patmakesapps/LumaLight/cad/LUMALIGHT_SPEC.md

# LumaLight — enclosure spec (v2.1, open back, 2026-10-12)

Modelled in `LumaLight.blend` (Blender 5.1, 1 BU = 1 mm). Assembly sits at the origin in **LUMALIGHT ASSEMBLY**
(`LUMALIGHT PRINT PARTS` + linked electronics in `LUMALIGHT PLACED PARTS`). Electronics are parked at x 300+ in
numbered collections; the L-mark and wordmark are in `LOGOS`. Body coordinates: X = width (centred), Y = depth
(front outer face y = 0, back of the panel y = 56), Z up from the counter. Cutaway views are in `views/`.

The print parts are generated by `build_lumalight.py` (CadQuery 2.8 on Python 3.12). It writes the print-oriented
STLs to `STL/` and assembly-oriented `asm_*.stl` meshes (to `%LUMALIGHT_ASM_DIR%`, default a temp folder) that are
imported into the blend to replace the part meshes. Change the numbers in the script, not the meshes.

## Why v2

v1 (bottom plate + spine, 40 deep) failed on the bench: the dupont housings on the ESP32 pins pointed at the
front wall with 0.5 mm to the ring pocket, and the ToF board had to be threaded down from the top past them with
its JST and cable attached (`bench reference/bad_design _01/_02.jpg`). v2 opens the **back** instead of the bottom,
hangs the ESP32 on the back panel, gives the wires an 18 mm bay, and makes the sensor a push-in-from-behind part.
Everything can be wired on the bench first.

## v2.1 (same day, after the sensor coupon)

The v2 pocket coupon showed the slit sitting about 3 mm below the real VL53L1X package, and the two snap fingers
barely holding the board. The board blockout had been eyeballed from photos (26.5 tall, package 21.5 up). The
CQRobot board is really 23 x 28.5 with R4 corners, both Ø3 holes at the top corners, the package 24.65 above the
cable edge. The ROLX-4 model of the board (`ROLX-4/cad/ROLX-4.blend`) is now appended and used in the assembly.
The sensor is screwed to two blocks instead of clipped, the window is re-centred on the package, and the ESP32
standoffs on the panel get a relieved neck (see the ESP32 row; the v2 panel already printed stays in use).

## Concept

An upright white monolith, 62 × 56 × 100 mm (body 53 deep + 3 mm back panel), vertical front edges chamfered 2.5,
top edges 1 mm. The front carries a Ø46 halo (transparent diffuser disc, NeoPixel ring behind it) and an 11 × 7 mm
rounded "visor" port for the ToF sensor below it. The LUMALIEN L-mark is recessed into the top face with purple
glued inlays; **LUMALIGHT** is recessed on the front near the base, **LUMALIEN** on the back panel. The back panel is
held by 4 screws into corner bosses; the USB-C cable leaves through a notch at the bottom of the panel.

## Layout (mm)

| Item | Position | Notes |
|---|---|---|
| Walls | 3.0 everywhere | cavity x ±28, y 3..53, z 3..97, open at the back |
| Halo | centre (0, z 65) | through hole Ø40; front recess Ø46 × 1.5 for the diffuser flange |
| Ring pocket rib | inner front wall, ID 37.4 / OD 44, y 3..9.5 | ring loads from the **front** through the Ø40 hole, LEDs forward, 0.3 radial play |
| Stop tabs | 3 tabs at 90°/210°/330°, 20° of arc, 1.5 inward, front face y 8.3 (45° underside to y 6.8 at the root) | ring back face rests at y 8.3; LED tops at y 4.7, 1.7 air gap to the diffuser; rotate the ring so its pads miss the tabs |
| Diffuser | flange Ø45.8 × 1.5 + boss Ø39.7 × 1.5, flush with the front | glued in; it captures the ring. Unchanged from v1 |
| Sensor window | 11 × 7 stadium through the wall, centre (0, z 36.95), 0.5 mm outward chamfer (12 × 8 at the face) | centred on the VL53L1X package. The 27° cone from the package (8.4 mm behind the face) needs 9 × 5.5 at the face, so there is about 1 mm of slack each way. Top of the flare is 1 mm below the diffuser recess |
| Sensor board | CQRobot VL53L1X, 23 wide × 28.5 tall, R4 corners, x ±11.5, PCB y 10..11.6, z 12.3..40.8, cable edge down | component side (package **and** 6-pin JST) faces the wall; package centre 24.65 above the cable edge; Ø3.0 holes at (±8.2, 37.6) = 25.3 above the cable edge; JST 16.6 wide × 4.6 tall at y 5.4..10, plug overhangs the edge 0.5; cable turns under the board in x ±7.1, 9.3 mm to the floor |
| Sensor mount | seats y 3..10 at \|x\| 10.5..15.7 (a 1 mm band under each board edge); cheeks y 10..12.7 at \|x\| 12.25..15.7 (0.75 play); both z 10.3..40.8. Screw blocks \|x\| 5.9..15.7, y 3..10, z 35.1..40.1, Ø2.0 pilots 6.5 deep at (±8.2, 37.6) | board is **pushed straight on from the back** between the cheeks until its face sits on the seats, then 2 × M2.5 × 6 self-tap through its top holes, driven from the open back. No bottom ledge, no fingers, nothing touching the rounded corners: the screws set the position. Blocks stop 0.4 short of the window |
| ESP32 | vertical on the back panel, USB-C down, bottom edge z 42, centred in X; PCB y 44.4..46, components toward the panel, pins toward the front | header plastic y 41.9..44.4, dupont housings y 27.9..41.9 |
| Wire bay | y 9.5 (rib back) .. 27.9 (housing tips) | 18.4 mm for the dupont leads to turn; 19.6 mm to the ring's back face; plus 14 mm of free channel each side of the ESP32, full depth |
| Standoffs (on the panel) | 4 × Ø6 × 7 at (±11.6, z 44.5) and (±11.6, z 91.3), Ø2.0 pilots 9 deep (into the panel, 1 mm short of the outer face). **v2.1:** the USB-end pair have an open-sided C neck for the first 3.6 mm from the PCB: Ø5, clipped 1.0 above the hole centre, nothing on the button side | the EN/BOOT buttons sit 1.5 mm above those two holes (z 46..52, 3.5 tall) and the v2 Ø6 standoffs pressed on them when tightened (bench). 4 × M2.5 self-tap: × 8 at the USB end so the screw reaches the full-round section, × 6 or × 8 at the top. The v2 panel in use is fine for this build |
| USB-C plug | hangs below the board, overmold centred y ≈ 47.6, keepout x ±6, y 44..51.5, z 14..41 | 1.5 mm to the panel; cable turns in the 11 mm above the floor |
| Back panel | 62 × 100 × 3 at y 53..56, back vertical edges chamfered 2.5, top-back edge 1.0 | 1.5 mm alignment lip (frame 1.5 wide, 55.4 × 93.4) enters the cavity; relieved at the corners and the notch |
| Panel screws | 4 at (±25, 6) and (±25, 94): Ø2.8 through, counterbore Ø5.5 × 1.5 from the outside | into 6 × 6 × 10 corner bosses in the body (y 43..53), Ø2.0 pilots 8 deep; M2.5 × 8 self-tap, driven from the back |
| Cable notch | 10 wide × 16 tall, rounded top, bottom centre of the panel, open at the bottom edge | cable exits backward along the counter |
| Top L-mark | 22 tall, centred on the top face (y 17..39), 1.2 deep | purple inlays unchanged (0.15 clearance, 1.4 thick → 0.2 proud); glue in |
| Text | LUMALIGHT front, centre z 11; LUMALIEN on the panel, centre z 23; Segoe UI Bold 7, 0.6 deep | |

## Print parts (5)

| Part | Material | Orientation |
|---|---|---|
| LUMALIGHT BODY | white | **front face on the bed**, open back up, no supports. The front gets the plate texture; every inner feature (rib, tabs, seats, blocks, bosses) grows straight up |
| LUMALIGHT BACK PANEL | white | outer face on the bed, standoffs and lip up, no supports |
| LUMALIGHT DIFFUSER | transparent | flange face down (bed texture frosts it) |
| LUMALIGHT LOGO INLAY L / TRI | purple | flat |
| TEST_SENSOR_POCKET (`STL/test/`) | any | front face down. 44 × 48 slab of the front wall with the pocket, window, screw blocks and floor stub, ~20 min. Print this before the body |

STLs in `STL/`, print orientation, 1:1 mm. Hardware: 4 × M2.5 × 6 self-tap (ESP32 top pair, sensor) and 6 × M2.5 × 8
self-tap (ESP32 USB-end pair, panel to body). No inserts, no magnets, every screw driven along its axis from
outside the part. Glue: diffuser, inlays.

## Assembly order (everything pre-wired)

1. On the bench: screw the ESP32 to the panel standoffs, components toward the panel, pins toward you. Feed the
   USB-C cable through the panel notch from the outside and plug it in. Plug the sensor's leads and the ring's
   leads onto the pins. The whole harness is now live and the body is still empty.
2. Sensor: hold the board by its edges with the JST toward the front wall and the cable hanging down. Push it
   straight into the pocket from the back between the cheeks until its face sits on the seats. Line the two top
   holes up on the pilots (you can see them through the holes) and run in 2 × M2.5 × 6. Tuck the cable under
   the board toward the back.
3. Ring: in from the front through the halo hole, wires first, LEDs facing out, until it seats on the three tabs.
   Turn it so the solder pads sit between tabs. The panel just lies behind the body while you do this; the leads
   are long enough to stay plugged in.
4. Glue the diffuser into the front recess. The ring is now captured.
5. Bring the panel up to the body, fold the dupont leads into the bay, seat the lip, 4 screws from the back.
6. Glue the purple inlays into the top recess.

To service it: 4 screws, the panel comes away with the ESP32 on it and everything stays plugged in.

## Verify on the bench before/after printing

- Sensor screw spacing: the pilots are 16.4 mm apart, between the vendor drawing (16.1) and the ROLX-4 model
  (16.8); the board's Ø3 holes give ±0.25 mm on an M2.5. Caliper the real centre spacing; outside 15.9..16.9 the
  pilots move.
- Window: with the board screwed into the coupon, both package apertures must be fully visible through the
  window with clear margin all round. The window is centred 24.65 mm above the cable edge (drawing and ROLX-4
  model agree); if the real package sits elsewhere the window moves, nothing else does.
- The JST is modelled 4.6 tall (ROLX-4 model) with 2.4 mm to the wall; the earlier 6 mm guess also cleared.
- Dupont housings modelled 14 mm long on 2.5 mm header plastic. Bay is 18.4 mm; the ring pads sit at y 8.3.
- Cable under the sensor: 9.3 mm from the cable edge to the floor (was 12 in v2; the board moved down with the
  real package height). Check the six silicone leads turn back without pushing on the board.

## Suggested print order

1. `STL/test/TEST_SENSOR_POCKET.stl` (~20 min): push the real board in, run the two screws, look through the
   window, check the cable turns under the board.
2. `LUMALIGHT_BACK_PANEL.stl` (v2.1 standoffs; the printed v2 panel is fine for this build): screw the ESP32 on
   with all leads plugged, hold a ruler against it. From the panel's inner face the housing tips reach 25 mm; the
   ring's back is 44.7 mm away, the front wall 50 mm.
3. Only then the body.

Views: `views/cutaway_sensor_pocket.png` and `views/cutaway_sensor_seated.png` show the v2.1 pocket;
`views/cutaway_assembly.png` is the v2 overview and still shows the old slit and fingers.
