patmakesapps/LumaLight/cad/bench reference/bad_design _01.jpg

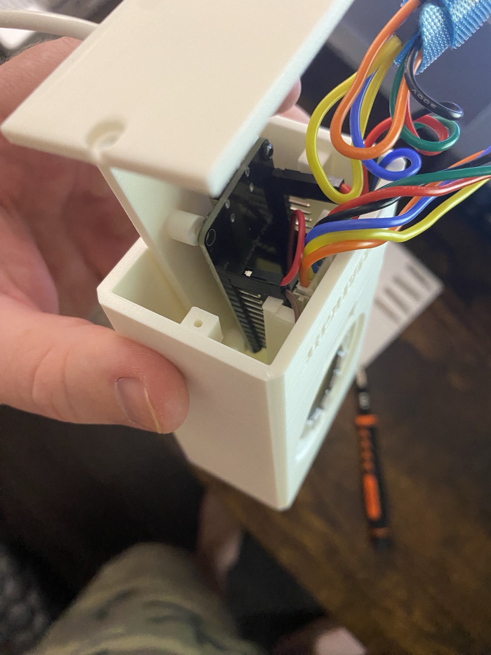
cad/bench reference/bad_design _01.jpg
