patmakesapps/LumaLight/cad/bench reference/bad_design _02.jpg

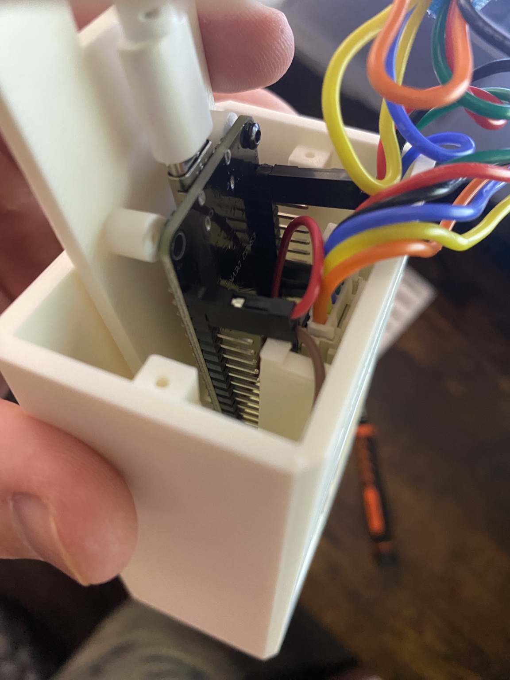
cad/bench reference/bad_design _02.jpg
