patmakesapps/LumaLight/cad/bench reference/bench_00.jpg

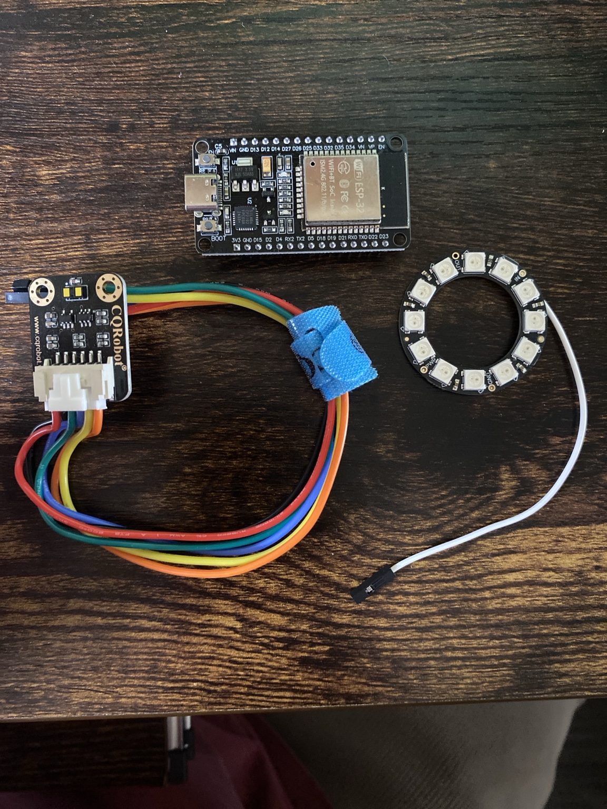
cad/bench reference/bench_00.jpg
