patmakesapps/LumaLight/cad/bench reference/distance_sensor_01.jpg

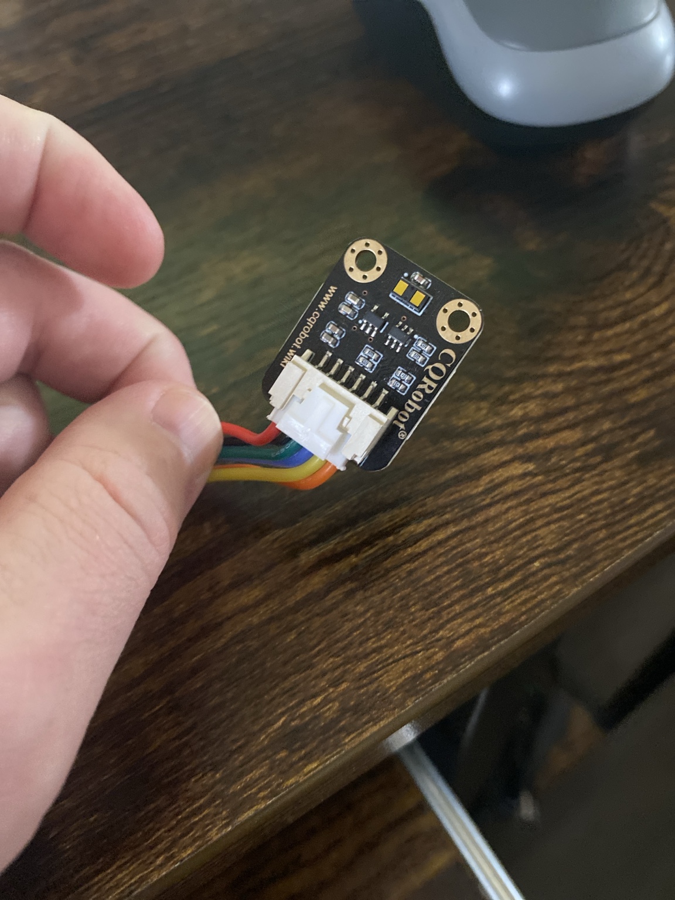
cad/bench reference/distance_sensor_01.jpg
