patmakesapps/LumaLight/cad/bench reference/esp_with_pins_02.jpg

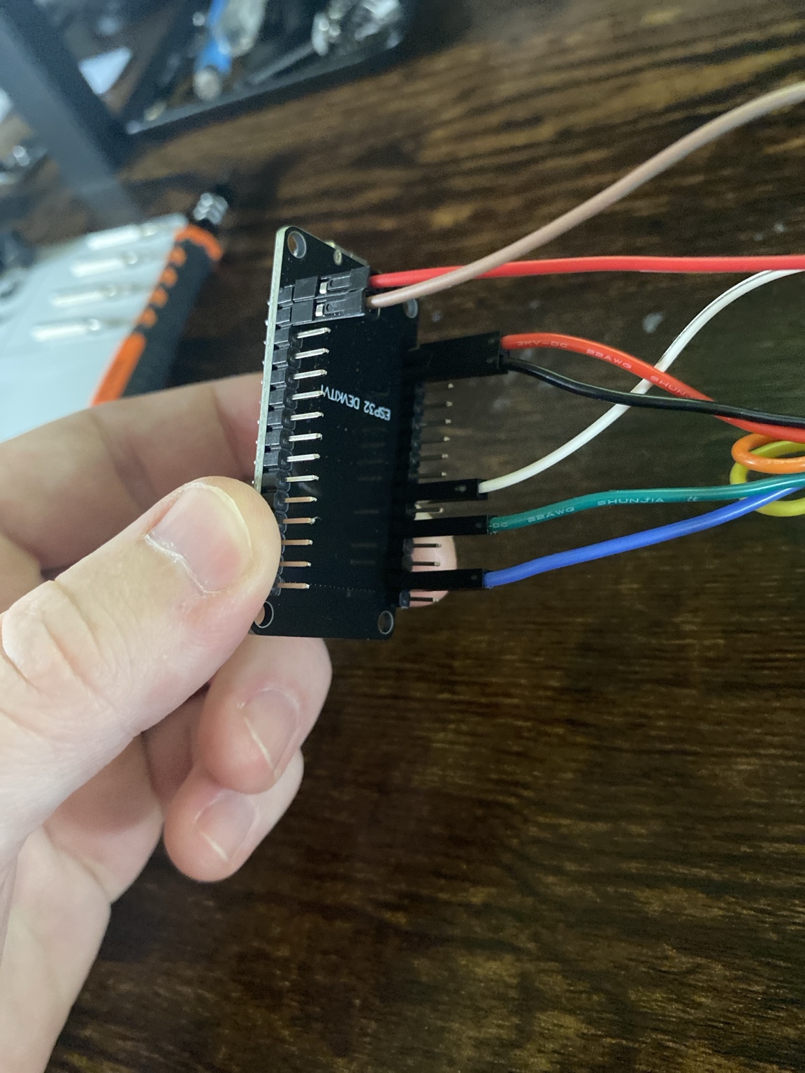
cad/bench reference/esp_with_pins_02.jpg
