patmakesapps/LumaLight/cad/bench reference/neo_pixel_rear_03.jpg

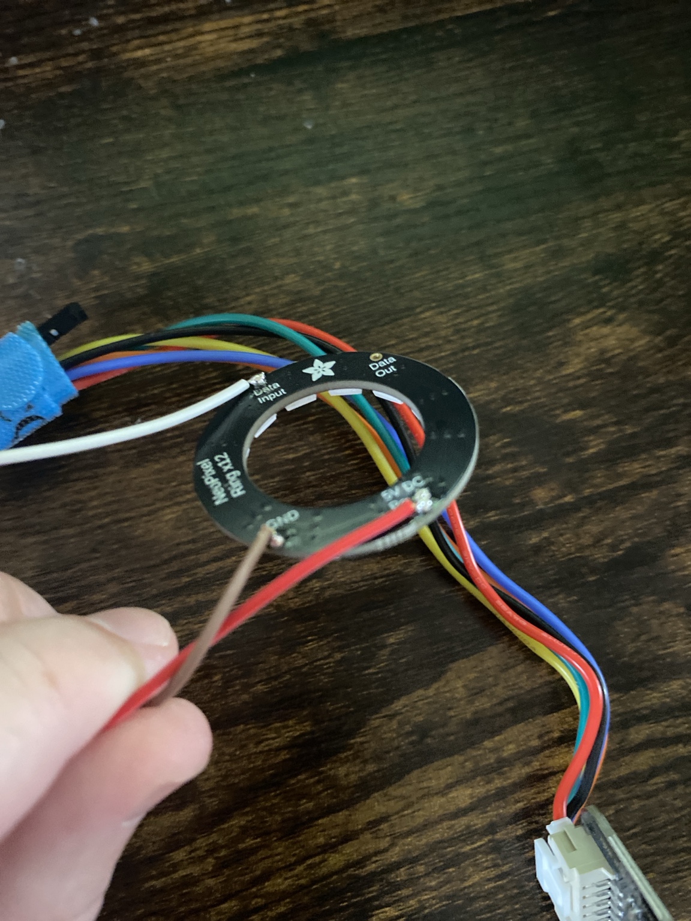
cad/bench reference/neo_pixel_rear_03.jpg
