patmakesapps/LumaLight/cad/views/cutaway_sensor_pocket.png

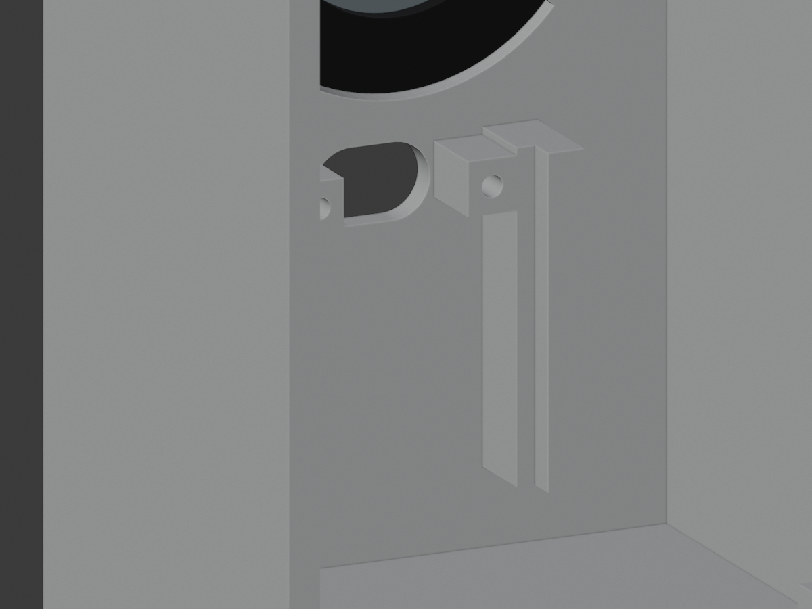
cad/views/cutaway_sensor_pocket.png
