patmakesapps/LumaLight/cad/views/cutaway_sensor_seated.png

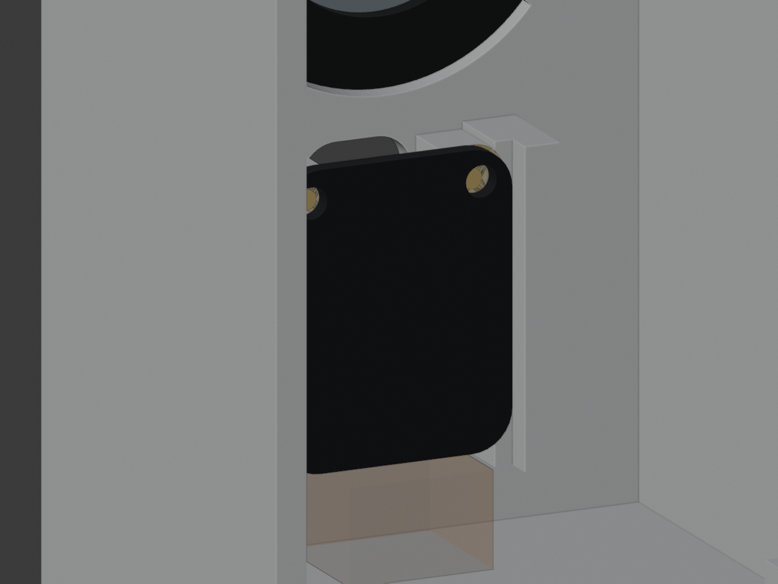
cad/views/cutaway_sensor_seated.png
