patmakesapps/LumaLight/cad/STL/LUMALIGHT_BODY.stl

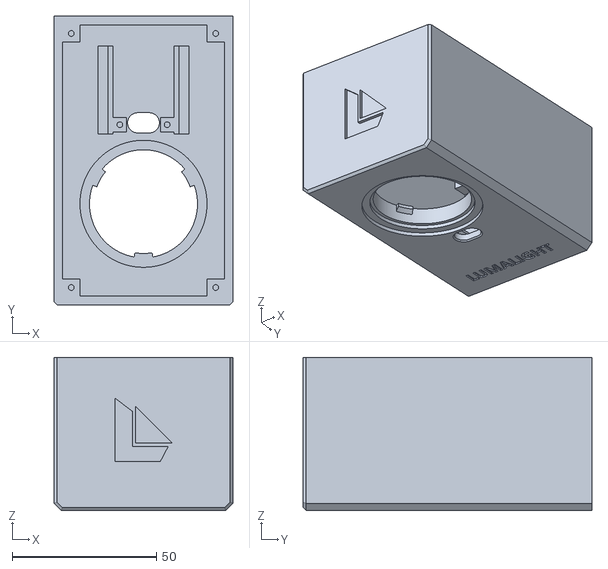
[picture p13: CAD file, 2026-10-13]
cad/STL/LUMALIGHT_BODY.stl
62.0 x 100.0 x 53.0
