patmakesapps/LumaLight/cad/STL/test/TEST_SENSOR_POCKET.stl

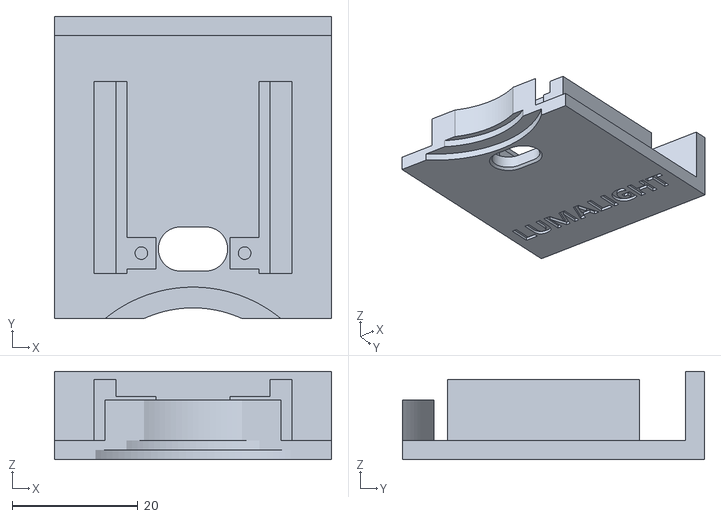
[picture p14: CAD file, 2026-10-13]
cad/STL/test/TEST_SENSOR_POCKET.stl
44.0 x 48.0 x 14.0
