patmakesapps/LumaLight/cad/STL/LUMALIGHT_BACK_PANEL.stl

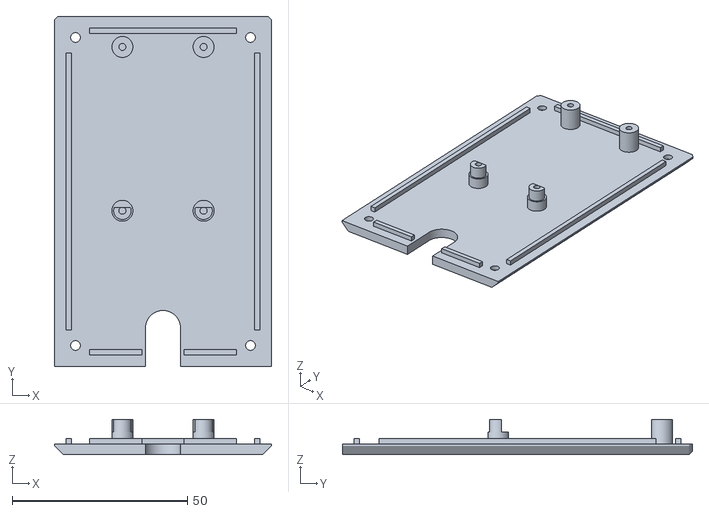
[picture p15: CAD file, 2026-10-13]
cad/STL/LUMALIGHT_BACK_PANEL.stl
62.0 x 100.0 x 10.00
