patmakesapps/LumaLight/cad/STL/LUMALIGHT_DIFFUSER.stl

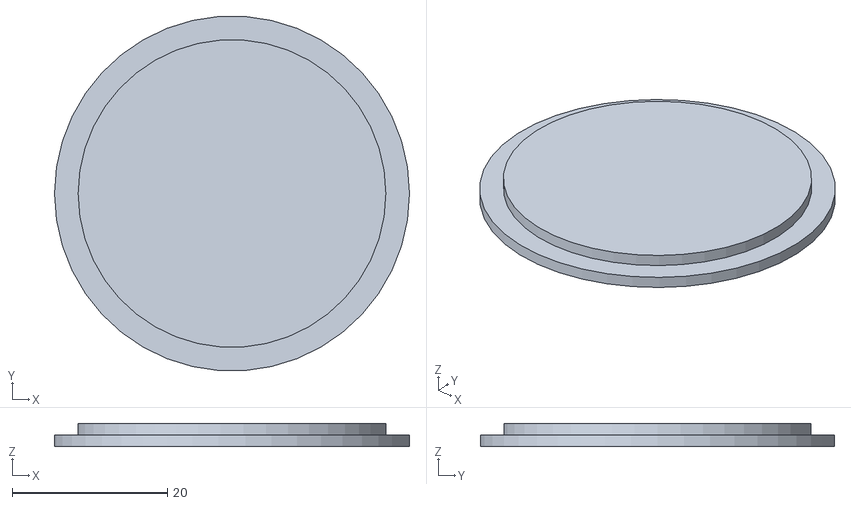
[picture p16: CAD file, 2026-10-12]
cad/STL/LUMALIGHT_DIFFUSER.stl
45.8 x 45.7 x 3.00
