patmakesapps/LumaLight/cad/STL/LUMALIGHT_LOGO_INLAY_TRI.stl

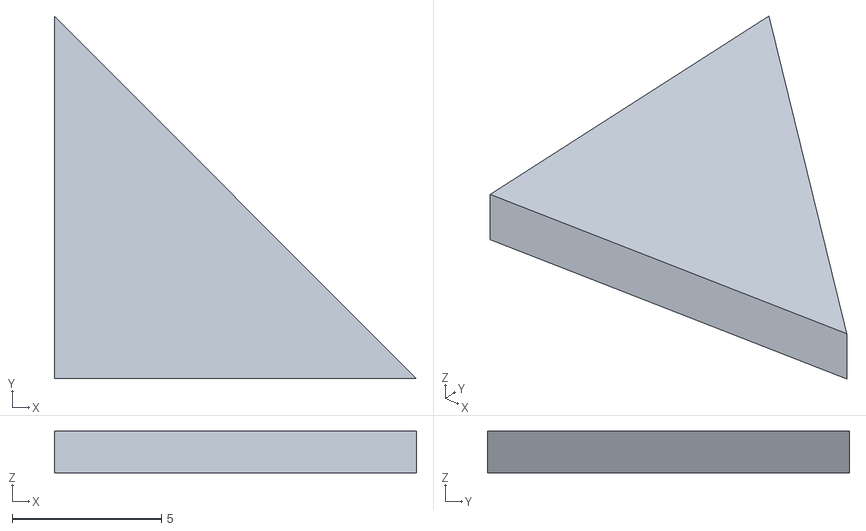
[picture p17: CAD file, 2026-10-12]
cad/STL/LUMALIGHT_LOGO_INLAY_TRI.stl
12.1 x 12.1 x 1.40
