patmakesapps/LumaLight/cad/STL/LUMALIGHT_LOGO_INLAY_L.stl

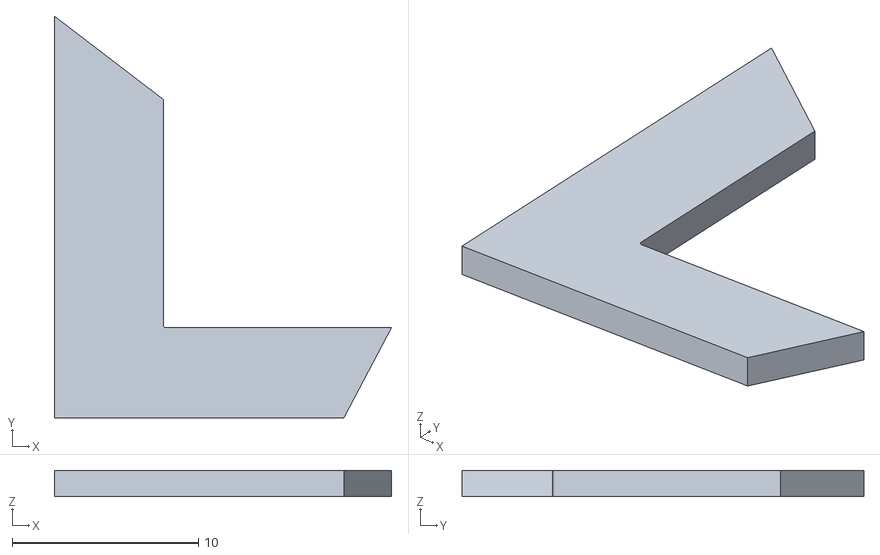
[picture p18: CAD file, 2026-10-12]
cad/STL/LUMALIGHT_LOGO_INLAY_L.stl
18.1 x 21.5 x 1.40
