patmakesapps/LumaLight/(list of files, cad)

Other CAD files:
cad/LumaLight.blend
