patmakesapps/LumaLight/cad/bench reference/full_assembly_04.jpg

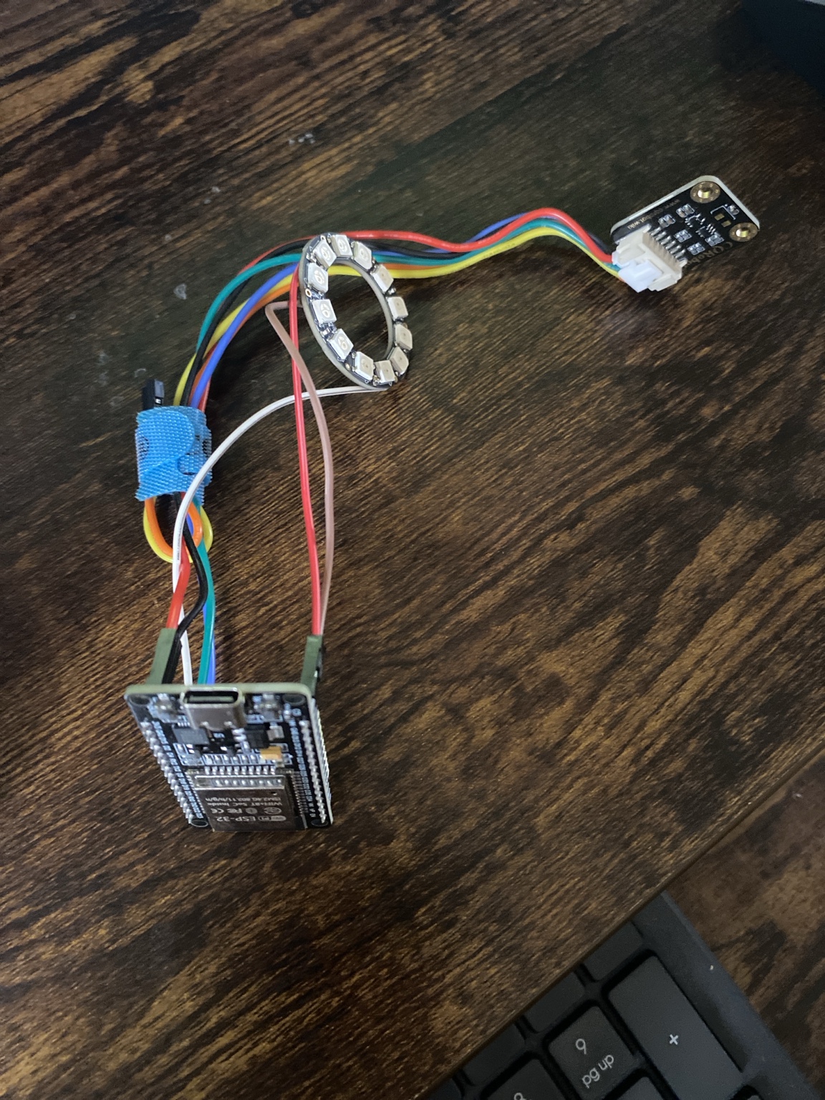
cad/bench reference/full_assembly_04.jpg
