patmakesapps/LumaLight/cad/views/cutaway_assembly.png

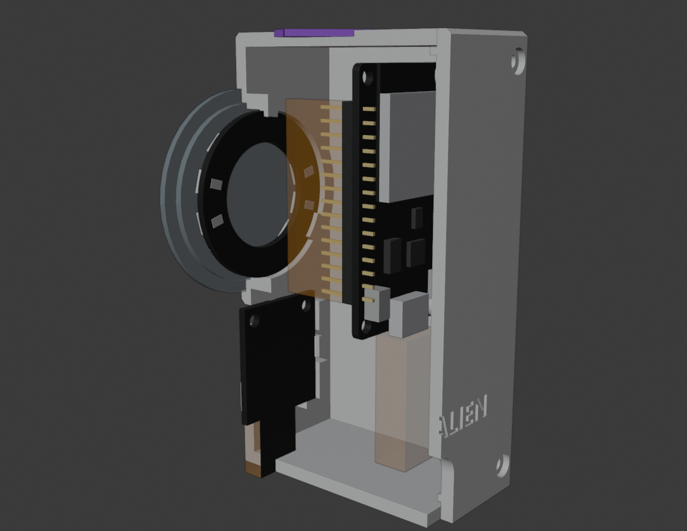
cad/views/cutaway_assembly.png
