patmakesapps/LumaLight/include/secrets.example.h

#pragma once

// Copy to include/secrets.h and fill in. secrets.h is git-ignored.
// 2.4 GHz networks only.
constexpr const char* WIFI_SSID = "your-network";
constexpr const char* WIFI_PASSWORD = "your-wifi-password";

// Must match --auth in secrets.ini
constexpr const char* OTA_PASSWORD = "choose-a-flashing-password";
