patmakesapps/LumaLight/(commit log)

2026-10-12 Add LumaLight enclosure CAD: Blender model, spec, STLs, bench reference
    Upright monolith enclosure (62 x 40 x 100 mm) designed around the bench
    hardware: ESP32 DevKit V1 (USB-C) on a base-plate spine, CQRobot VL53L1X
    in slide-in rails behind a visor slit, NeoPixel ring 12 front-loaded into
    a tabbed pocket behind a glued transparent diffuser. Recessed L-mark on
    top with purple inlays, LUMALIGHT / LUMALIEN text front and back, cable
    notch at the back-bottom.
    cad/LumaLight.blend model, 1 BU = 1 mm, electronics blockouts + logos
    cad/LUMALIGHT_SPEC.md layout numbers, print list, hardware, assembly order
    cad/STL/ 5 print parts, print orientation, watertight
    cad/bench referenc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
    [LUMALIGHT_BASE_PLATE.stl, LUMALIGHT_BODY.stl, LUMALIGHT_DIFFUSER.stl, LUMALIGHT_LOGO_INLAY_L.stl, LUMALIGHT_LOGO_INLAY_TRI.stl, LumaLight.blend]
2026-10-12 Base plate prints spine-down; ring pocket front-loads, retainer removed
    - Ring now loads from the front through the halo hole and seats on three
    tabs at the back of the rib pocket; the glued diffuser captures it. The
    screwed retainer (unreachable with a driver inside the cavity) is gone.
    - Base plate + spine re-exported lying on its back: spine face on the bed,
    ESP32 standoffs printing as vertical cylinders. Spine made flush with the
    plate edge so both sit on the bed.
    - Sensor rail stops overlap the lips face-to-face; all STLs verified
    watertight.
    - Spec and print notes updated. 5 print parts.
    [LUMALIGHT_BASE_PLATE.stl, LumaLight.blend]
2026-10-13 Enclosure v2: open back, panel-mounted ESP32, push-in sensor pocket
    v1 failed on the bench (cad/bench reference/bad_design_*.jpg): the dupont
    housings on the ESP32 pins had 0.5 mm to the ring pocket and the ToF board
    had to be threaded down rails past them with its JST attached.
    - Body is now a cup open at the back, 62 x 56 x 100 (53 + 3 mm panel).
    Prints front face down, no supports.
    - Back panel carries the ESP32 on 4 standoffs, pins toward the front,
    18 mm wire bay to the ring rib plus 14 mm free each side of the board.
    4 x M2.5 x 8 from the back into corner bosses; USB-C notch at the bottom.
    - ToF sensor pushes straight in from the back onto seats and clicks behind
    two snap fing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
    [LUMALIGHT_BACK_PANEL.stl, LUMALIGHT_BASE_PLATE.stl, LUMALIGHT_BODY.stl, LumaLight.blend, TEST_SENSOR_POCKET.stl]
2026-10-13 Sensor pocket v2.1: screwed to two blocks, real board model, ESP32 standoff necks
    The v2 coupon put the slit ~3 mm below the VL53L1X package and the snap
    fingers barely held. The CQRobot board is 23 x 28.5 with R4 corners and
    both holes at the top corners; the ROLX-4 model of it is appended and
    used in the assembly.
    - Sensor pushes in from the back onto 1 mm seats between loose cheeks
    (0.75 play) and is held by 2 x M2.5 x 6 into blocks at its top holes.
    No ledges or fingers, nothing at the rounded corners.
    - Window is an 11 x 7 stadium centred on the package (z 36.95); board
    z 12.3..40.8, 9.3 mm under it for the cable.
    - Panel: USB-end ESP32 standoffs get an open-sided neck so the EN/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
    [LUMALIGHT_BACK_PANEL.stl, LUMALIGHT_BODY.stl, LumaLight.blend, TEST_SENSOR_POCKET.stl]
2026-10-13 Firmware: turn on when the range changes from a snapshot
    The old rearm needed the view to clear past 1.7 m, so in a bathroom with a
    nearby wall the light never rearmed and only a close hand woke it. Now the
    light snapshots the range when it goes off (and at boot) and turns on when
    a reading moves more than 150 mm from it, either way, twice in a row.
    Replaces the 5 ft trigger, cooldown and hand-wave mode.
    [main.cpp]
2026-10-13 Firmware V1.2: flash over Wi-Fi, README
    ArduinoOTA as lumalight.local, flashed with `pio run -e ota -t upload`.
    Wi-Fi and flashing passwords live in git-ignored include/secrets.h and
    secrets.ini (examples committed). Without secrets.h it builds as before,
    USB-only. The light never waits on Wi-Fi.
    Adds a README covering hardware, the trigger logic, build and Wi-Fi
    flashing.
2026-10-13 Add BOM.md and product photos to the README
2026-10-13 Gift build: no Wi-Fi, for lights given to other people
    Adds a gift env that builds with NO_WIFI, so Wi-Fi credentials and the
    flashing password are left out even when include/secrets.h exists.
    README covers flashing and handing over a gift light. Also includes the
    current LumaLight.blend.
    [LumaLight.blend]
